MakeMagazinDE/Kapazit-Messg/kap_m_v01 - Schematic neu.pdf

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

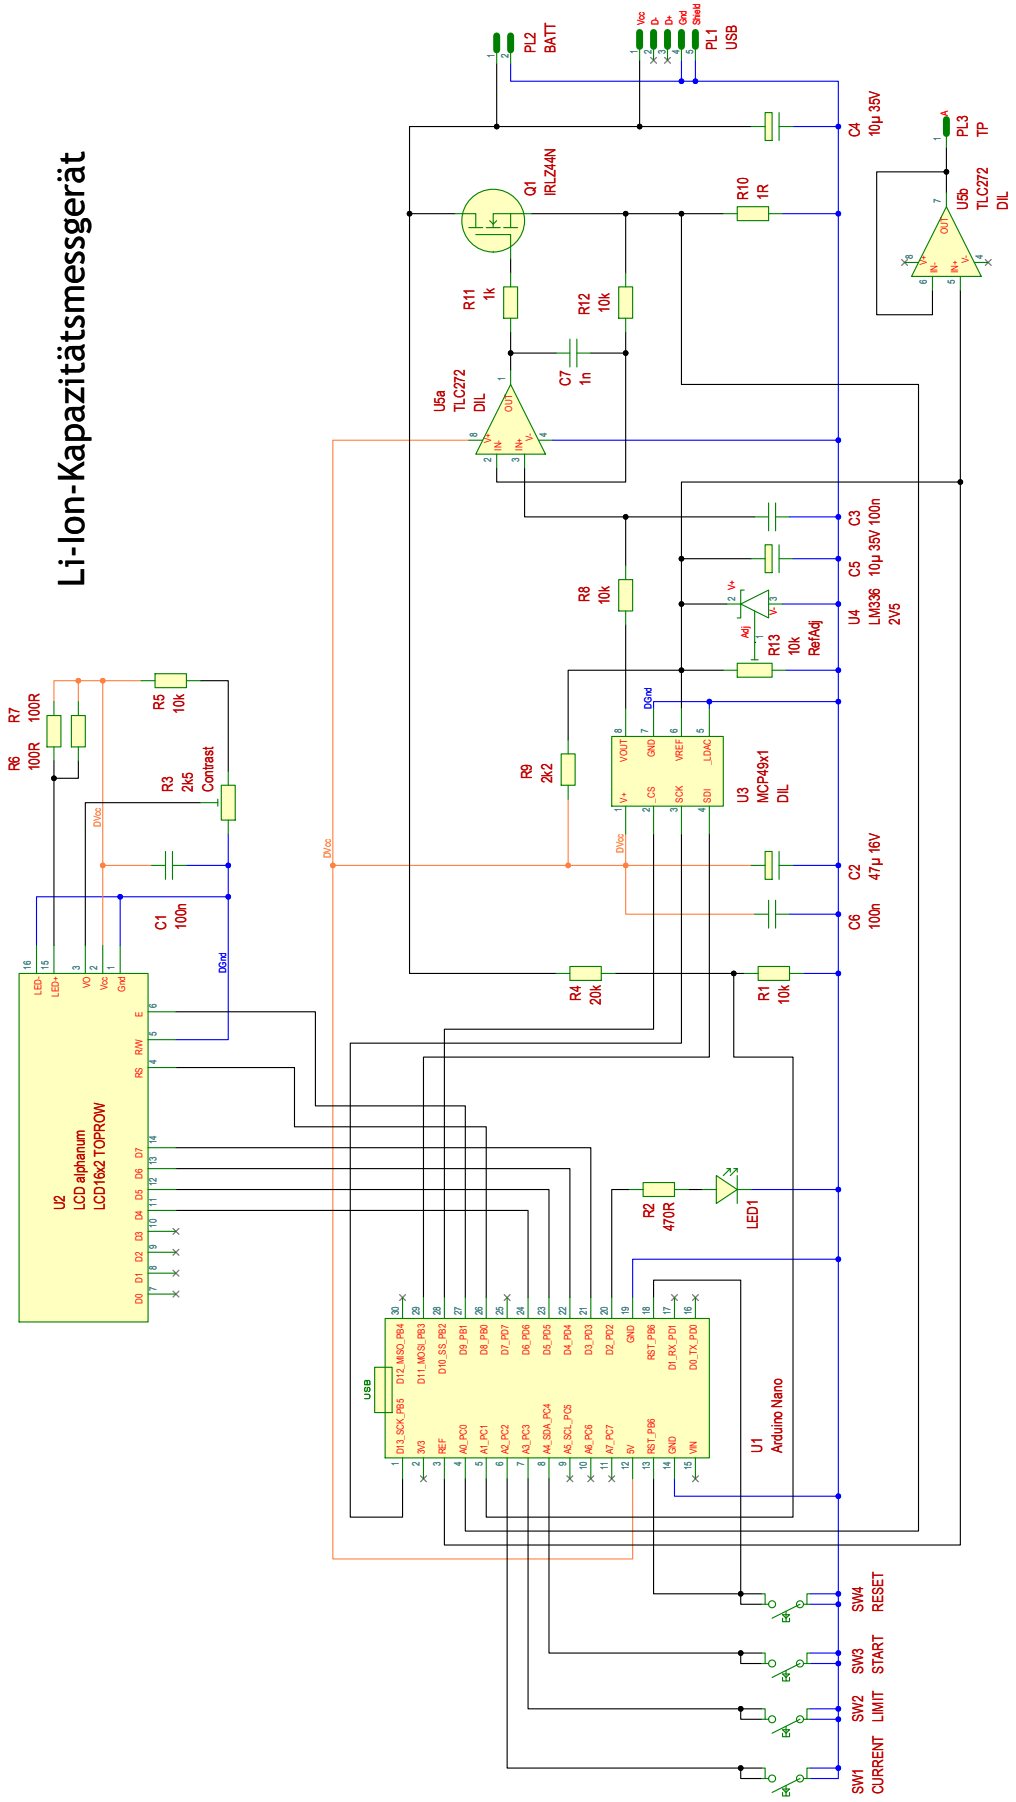
[picture p2: page 1]
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
