MakeMagazinDE/Kapazit-Messg/kap_m_v01 - PCB_neu.pdf

C4

PL2

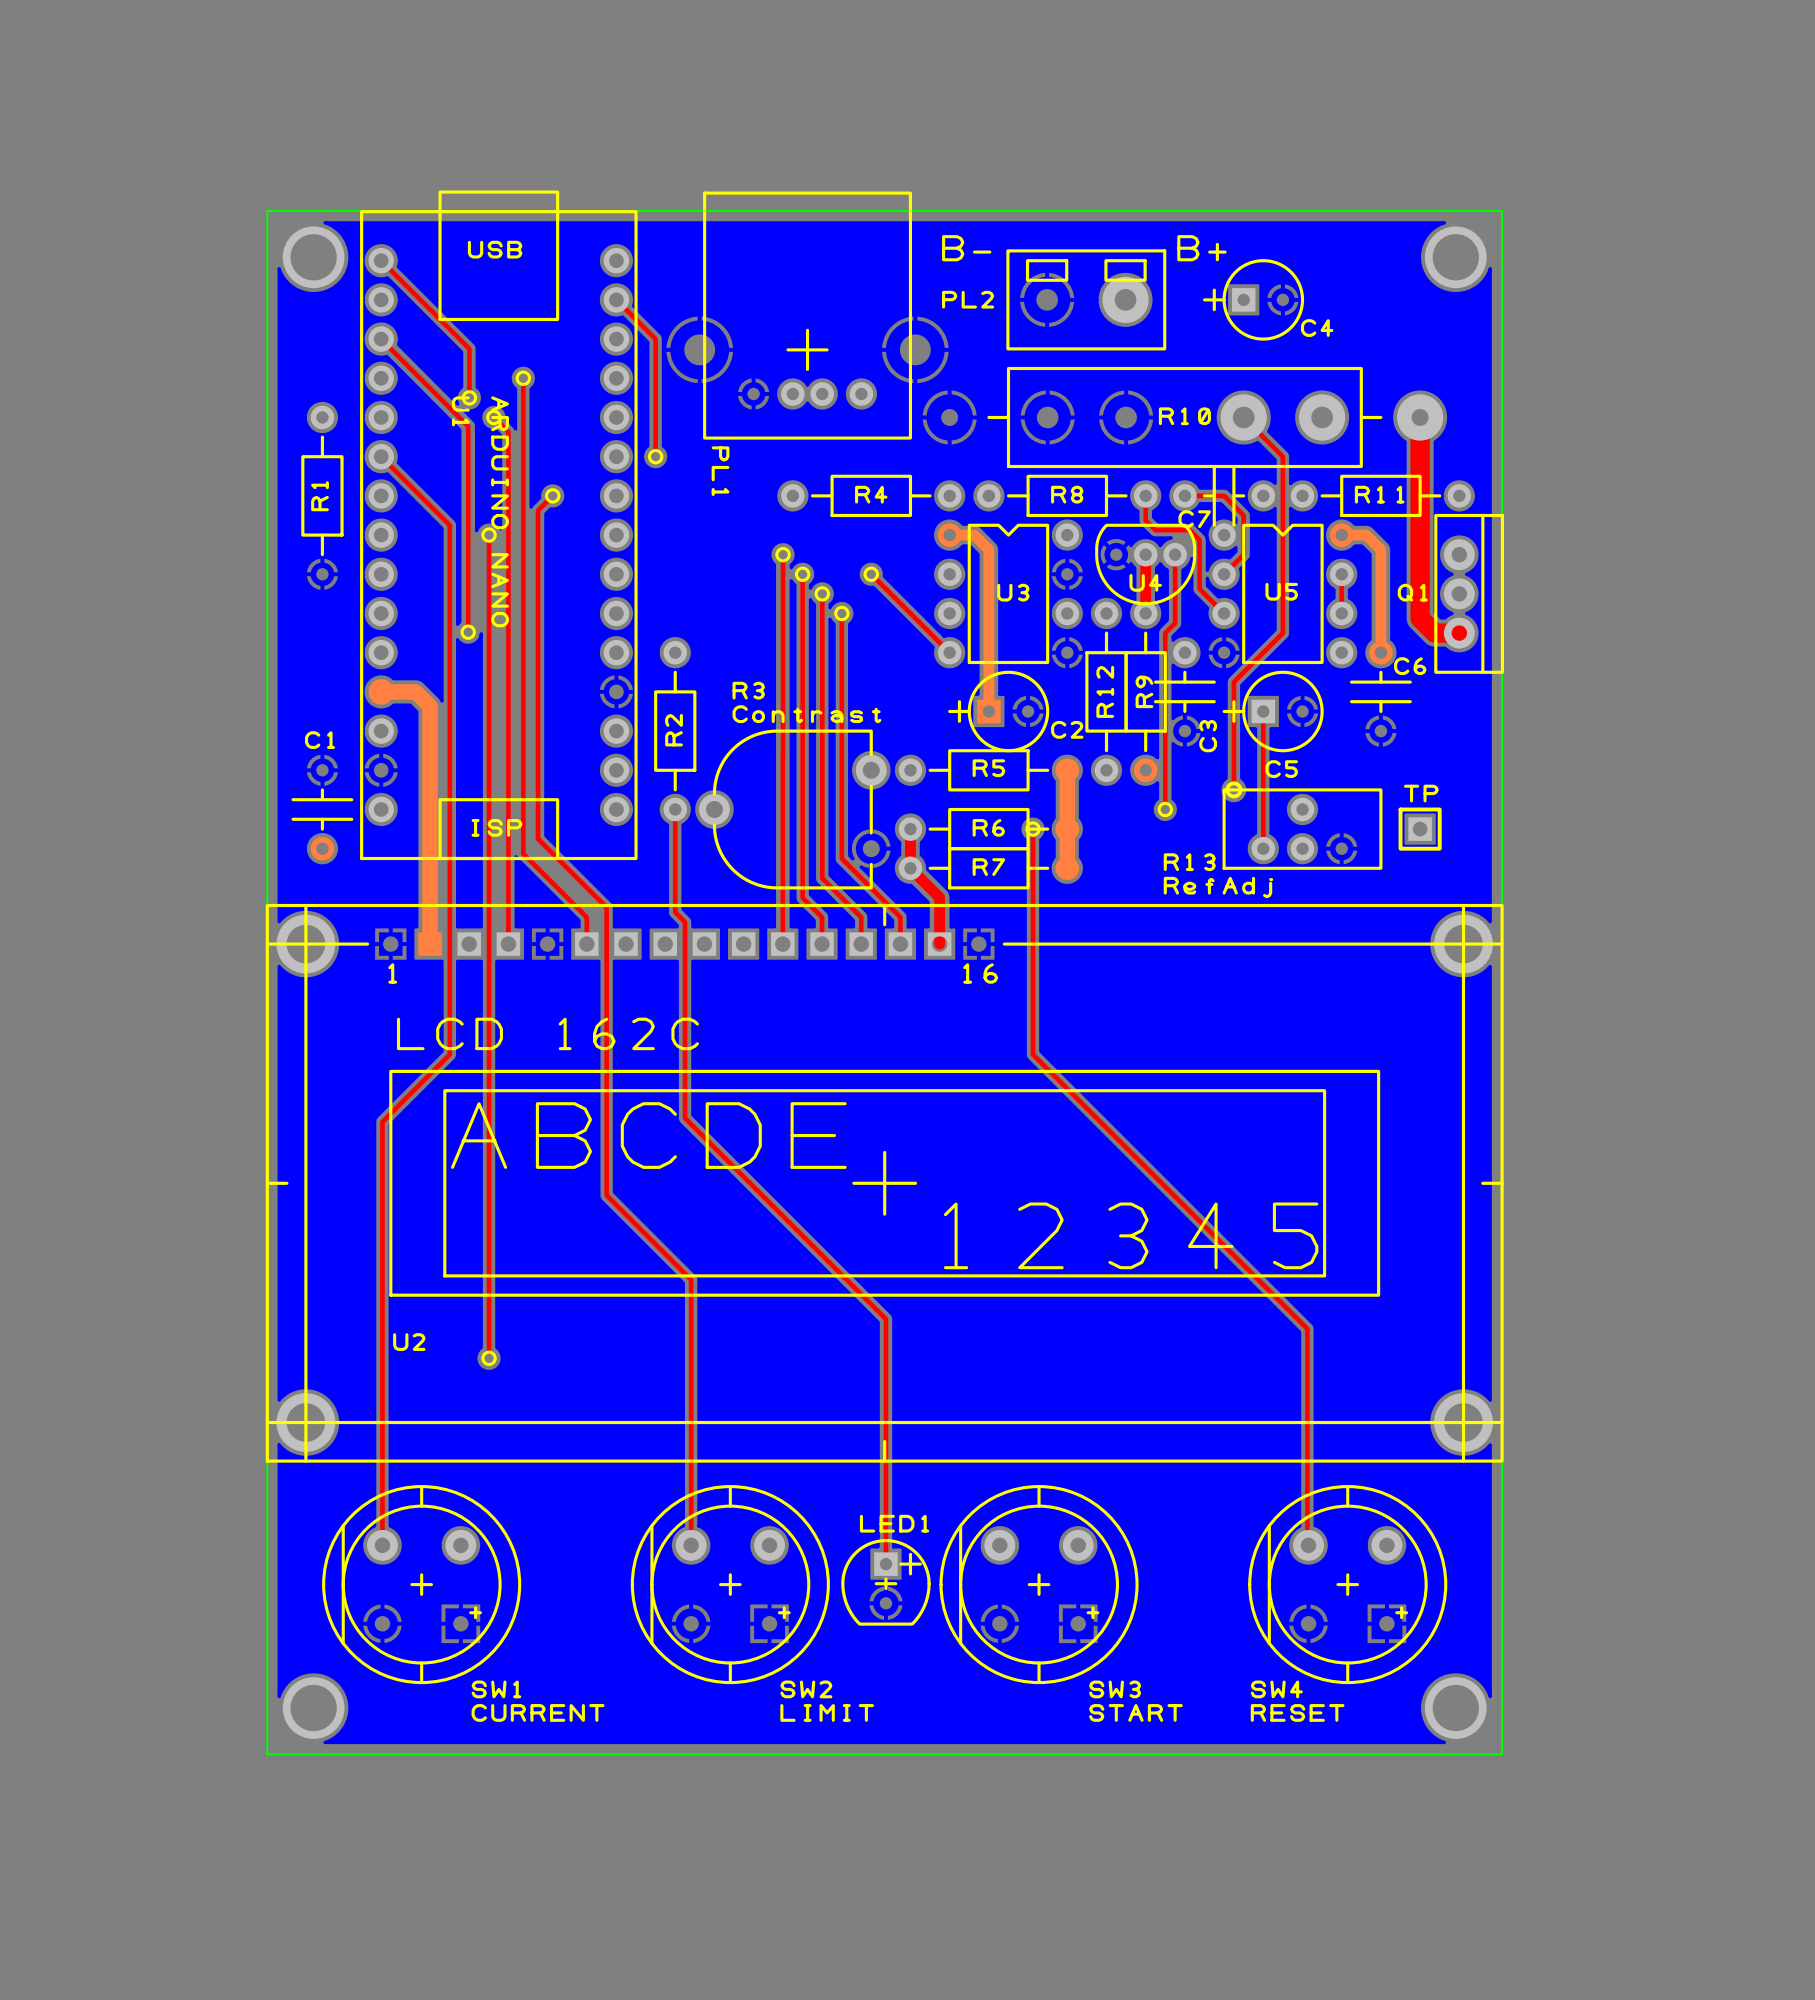
[picture p3: page 1]
